mattudakis/ArduinoLEDClock/LEDPCB/PCB_LED_bottom.png

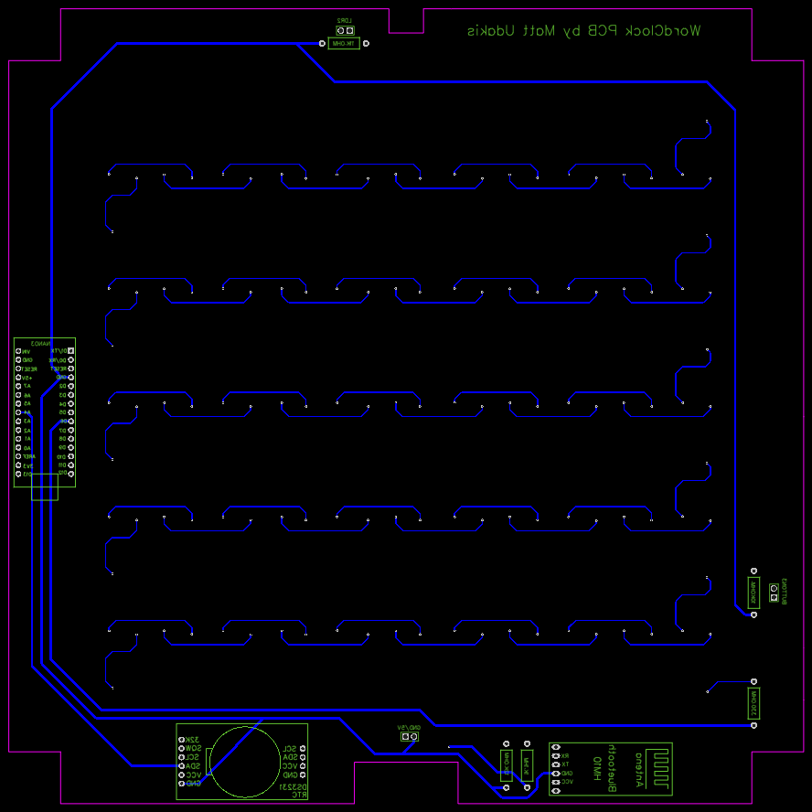
LEDPCB/PCB_LED_bottom.png
