mattudakis/ArduinoLEDClock/LEDPCB/PCB_LED_top.png

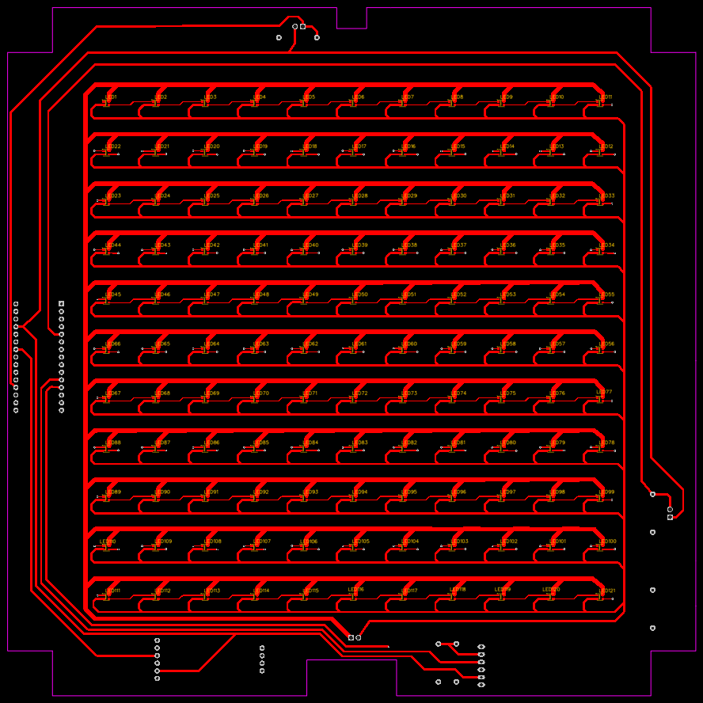
LEDPCB/PCB_LED_top.png
