mattudakis/ArduinoLEDClock/LEDPCB/BOM_LED_array_extra_reconfig_2023-05-14.csv

ID | Name | Designator | Footprint | Quantity | Manufacturer Part | Manufacturer | Supplier | Supplier Part | Price
1 | LED-SMD_4P-L2.0-W2.0-TL_WS2812B-2020 | LED84,LED85,LED86,LED87,LED88,LED1,LED2,LED3,LED4,LED5,LED6,LED7,LED8,LED9,LED10,LED11,LED12,LED13,LED14,LED15,LED16,LED17,LED18,LED19,LED20,LED21,LED22,LED23,LED24,LED25,LED26,LED27,LED28,LED29,LED30,LED31,LED32,LED33,LED34,LED35,LED36,LED37,LED38,LED39,LED40,LED41,LED42,LED43,LED44,LED45,LED46,LED47,LED48,LED49,LED50,LED51,LED52,LED53,LED54,LED55,LED56,LED57,LED58,LED59,LED60,LED61,LED62,LED63,LED64,LED65,LED66,LED67,LED68,LED69,LED70,LED71,LED72,LED73,LED74,LED75,LED76,LED77,LED78,LED79,LED80,LED81,LED82,LED83,LED89,LED90,LED91,LED92,LED93,LED94,LED95,LED96,LED97,LED98,LED99,LED100,LED101,LED102,LED103,LED104,LED105,LED107,LED108,LED109,LED110,LED111,LED112,LED113,LED114,LED115,LED116,LED117,LED118,LED119,LED120,LED121,LED106 | LED-SMD_4P-L2.0-W2.0-TL_WS2812B-2020 | 121
2 | DS3231 | U3 | DS3231 | 1
3 | 330 ohm | 330.OHM | AXIAL-0.5 | 2
4 | button header | BUTTON3 | HDR-2X1/2.54 | 1
5 | ARDUINO_NANO | NANO3 | ARDUINO_NANO | 1
6 | LDR | LDR2 | HDR-2X1/2.54 | 1
7 | 10k | 10K.OHM | AXIAL-0.5 | 1
8 | 2k | 2K.OHM | AXIAL-0.5 | 1
9 | 1k | 1K.1HM | AXIAL-0.5 | 1
10 | Bluetooth | HM11 | BLUETOOTH HC05 HM10 | 1
11 | LED in | GND/5V | HDR-2X1/2.54 | 1
