mattudakis/ArduinoLEDClock/other_workings/fabrication/WordClock_deviders_1.5mmedited.png

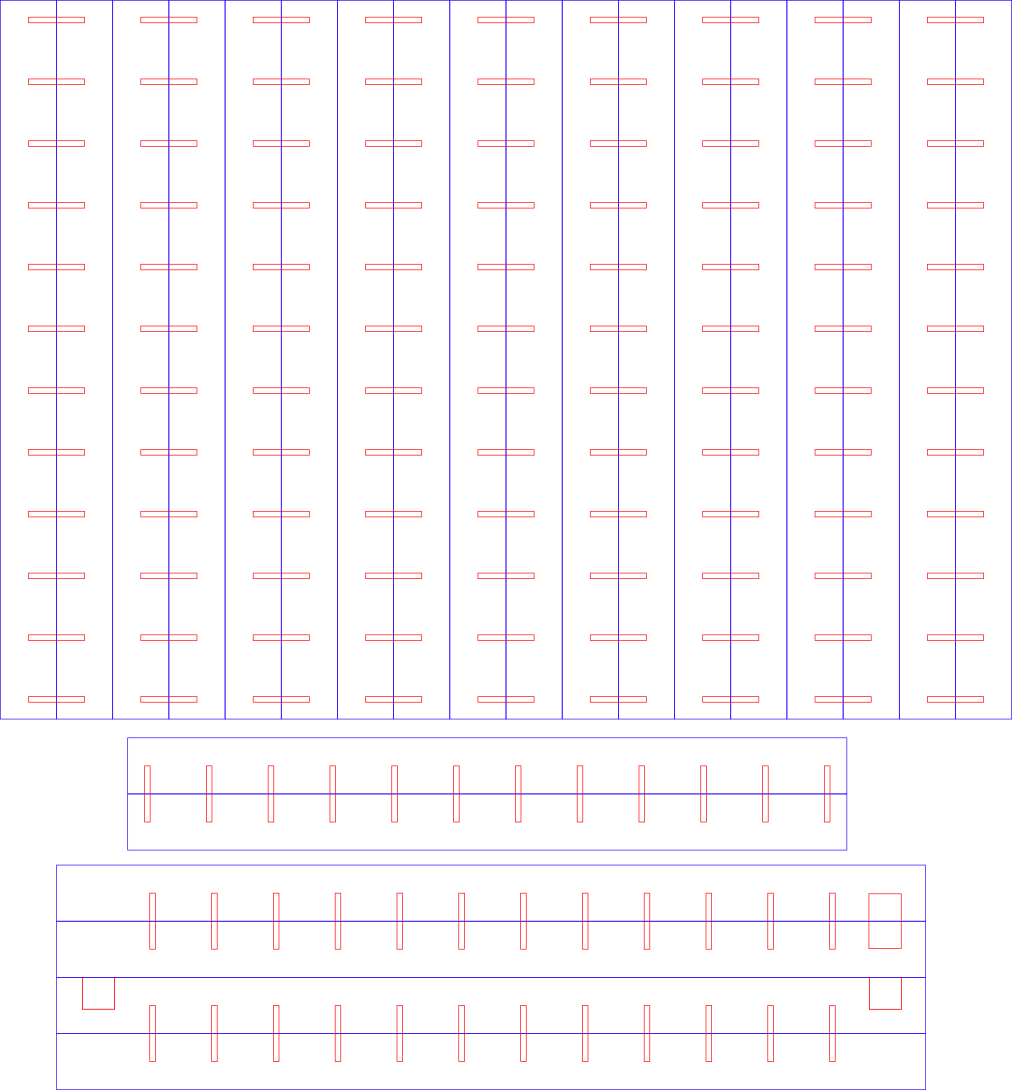
other_workings/fabrication/WordClock_deviders_1.5mmedited.png
