mattudakis/ArduinoLEDClock/(threads)

Thread 1 (2022-09-05):

Add eprom memory functionality

mattudakis, 2022-09-05:
Use the eprom memory of the ardunio board to save user settings
settings to save include:
- LED hue
- Birthdays set via bluetooth
- Brightness thresholds set via bluetooth

mattudakis, 2023-05-14:
This has been addressed and used for storing birthdays that be added and deleted from the eprom memory

Closed 2023-05-14.

Thread 6 (2023-02-25):

SVG Units

AeroSteveO, 2023-02-25:
what are the units in the SVG files, inkscape is reading them as 172mm across rather than 230mm across. The center to center distance on the LED template is also 12mm and not 16.5mm, so the LED strip size called out won't fit the cutouts. The dividers have the slots at 1.5mm which matches the called out material sizes, however the length of them too is for a much smaller layout than the 9"x9" one called out.

mattudakis, 2023-02-27:
It apears that Inkscape has a known issues when importing SVGs with setting incorrect scales.
This can be corrected as shown here: https://www.youtube.com/watch?v=9qiYQDcmmQc

Unfortunatly if you correct the scale issue in inscape and then resave the .svg the dimentions are then incorrect in other vector based softwares such as adobe illustrator

I will update the readme and add additional files specific for inkscape

The correct dimentions for the WordClock_LED_template and the WordClock_Front_text should be 230mm x 230mm
It looks like the WordClock_deviders_1.5mm file has been edited incorrectly due to this issue, which I will rectify.

AeroSteveO, 2023-02-27:
I saw the same problem in LightBurn and CATIA as well. The scaling issue was strangest with the dividers where the slots were the correct 1.5mm while the rest of the size matched the smaller clock size at 7" or about a 12mm LED spacing.

mattudakis, 2023-02-27:
>

Having researched into this a bit more, it seems this is actually an adobe illustrator issue rather than an Inkscape problem.
adobe exports .svgs with a 96ppi whereas the standard for .svgs is 72ppi which is why you were having issues with LightBurn and CATIA as well. I will fix the files to make them fit to the standard 72ppi and upload the files again.

mattudakis, 2023-02-27:
The following commit ( 36f0f84 ) should have fixed this issue. I'll update the readme as well to mention compatability issues with adobe illustrator.

Closed 2023-02-27.

Thread 8 (2023-05-14):

The RTC doesnt seem to keep time after powering down

mattudakis, 2023-05-14:
When powering down the clock doesnt seem to keep the correct time as previously. Might be due to the release of new DS3232RTC libraries

mattudakis, 2023-05-14:
This is now resolved. In version 2.0 and onwards of the DS3232RTC library. RTC.begin() is needed in the setup void.
This is detailed in the documentation for this library

Closed 2023-05-14.

Thread 9 (2023-07-01):

Bluetooth serial input won't work with \r carriage return

mattudakis, 2023-07-01:
currently only detects strings with a new line '\n'. If '\r\n' is sent together, Bluetooth commands are not detected correctly. BLE apps by default send '\r\n' forcing users to alter settings. To fix Need to insert logic to detect if string contains '\r' after parsing input and remove.
Alternatively could do read string until '/r' or '/n'

Thread 10 (2023-07-30):

Add smoothing to analogue brightness read.

mattudakis, 2023-07-30:
In lower light conditions the mapping of analogue photo resistor to FastLED brightness leads to fluctuations. A simple box filter should hopefully stop this.

Can use built in arduino smooth() example
