mattudakis/ArduinoLEDClock/Fabrication/Backplate_0_01pt_with_engrave.pdf

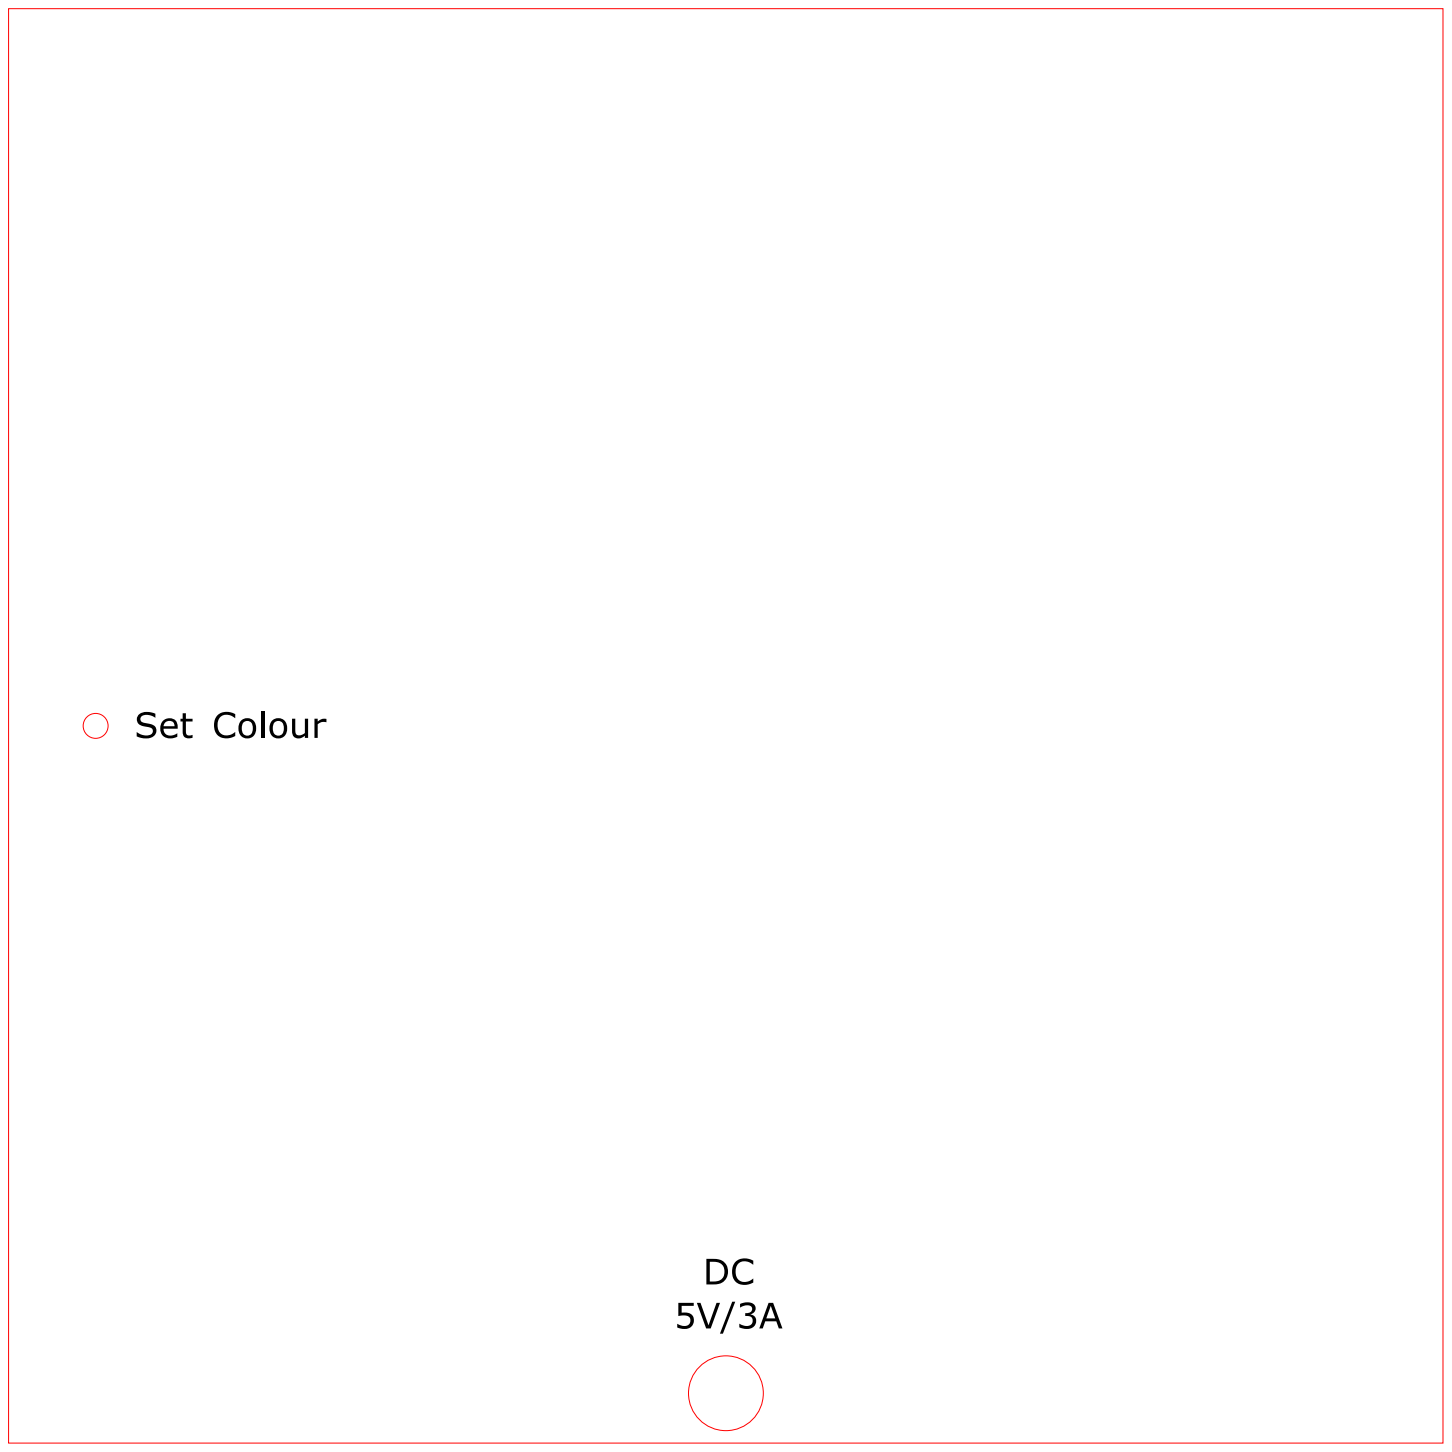
[picture p26: page 1]
