mattudakis/ArduinoLEDClock/Fabrication/WordClock_Front_text.pdf

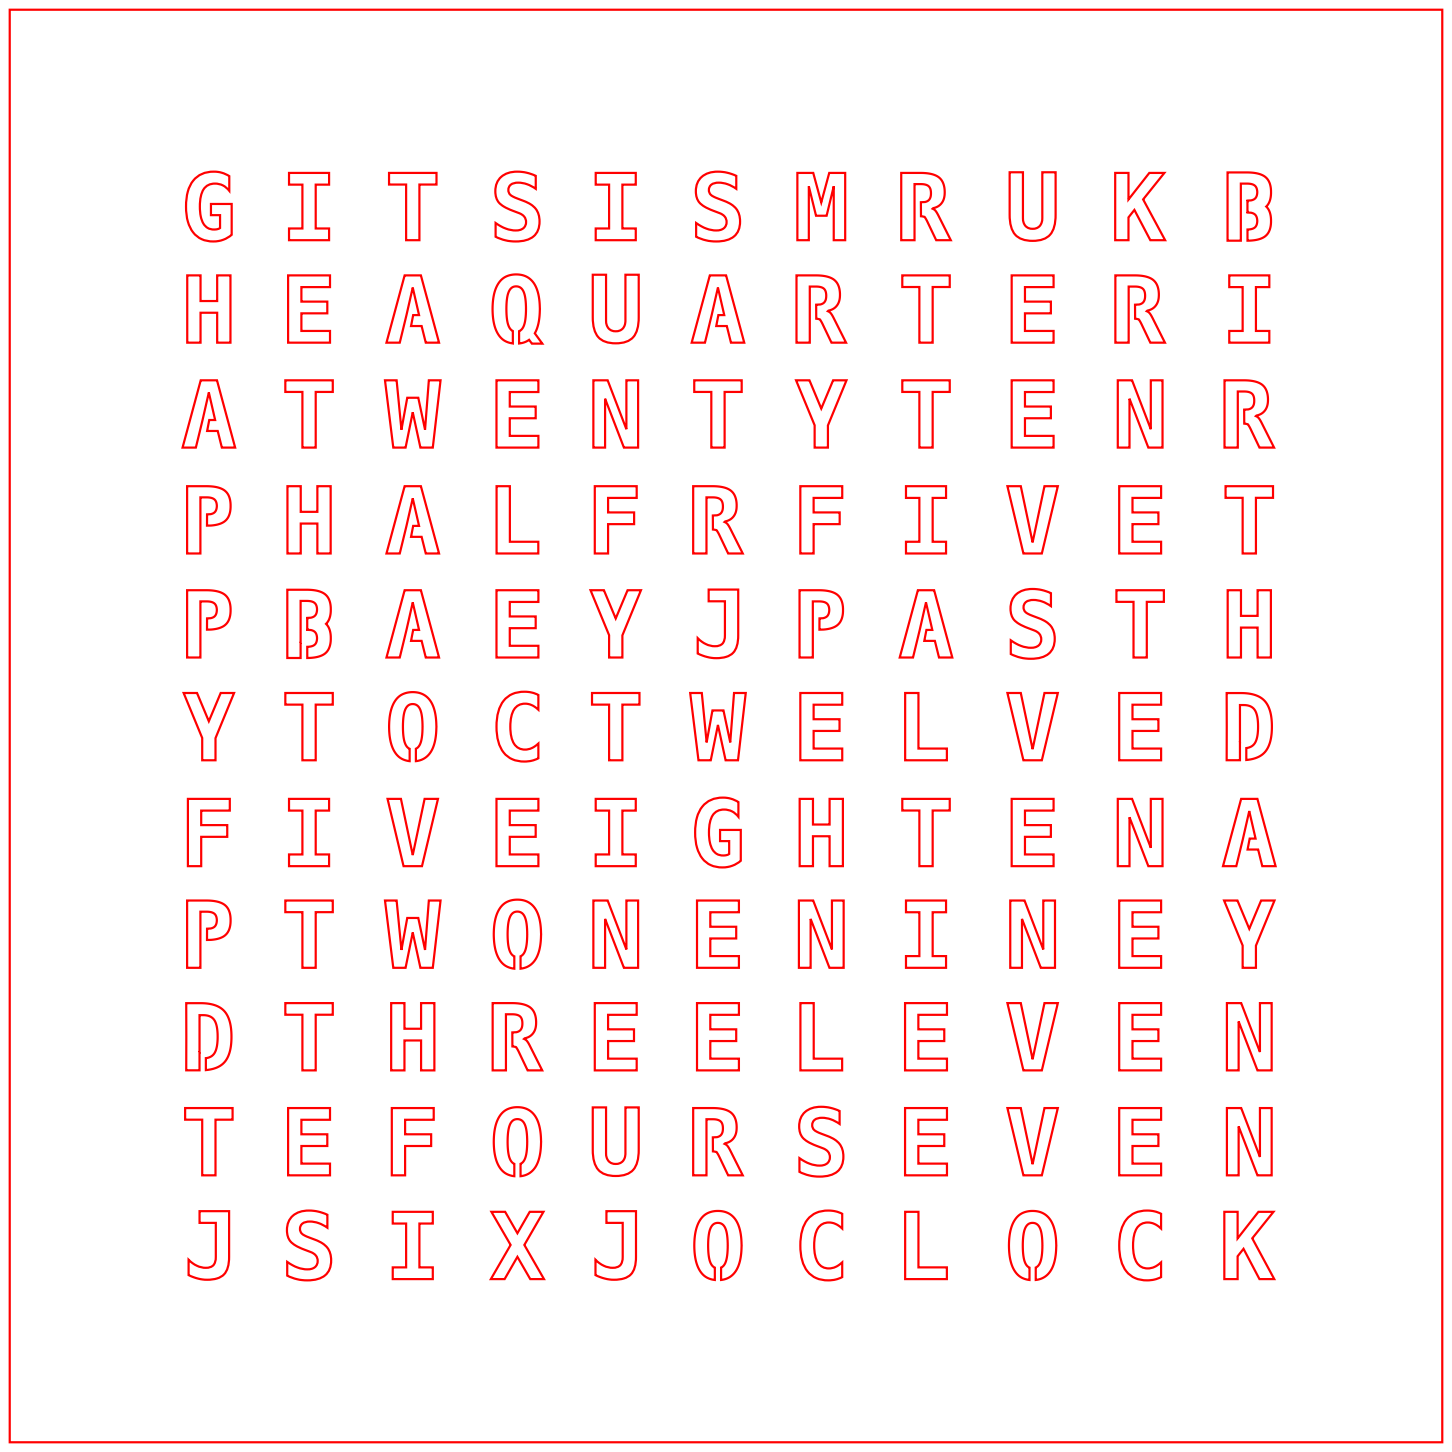
[picture p27: page 1]
