mattudakis/ArduinoLEDClock/Fabrication/WordClock_LED_template.pdf

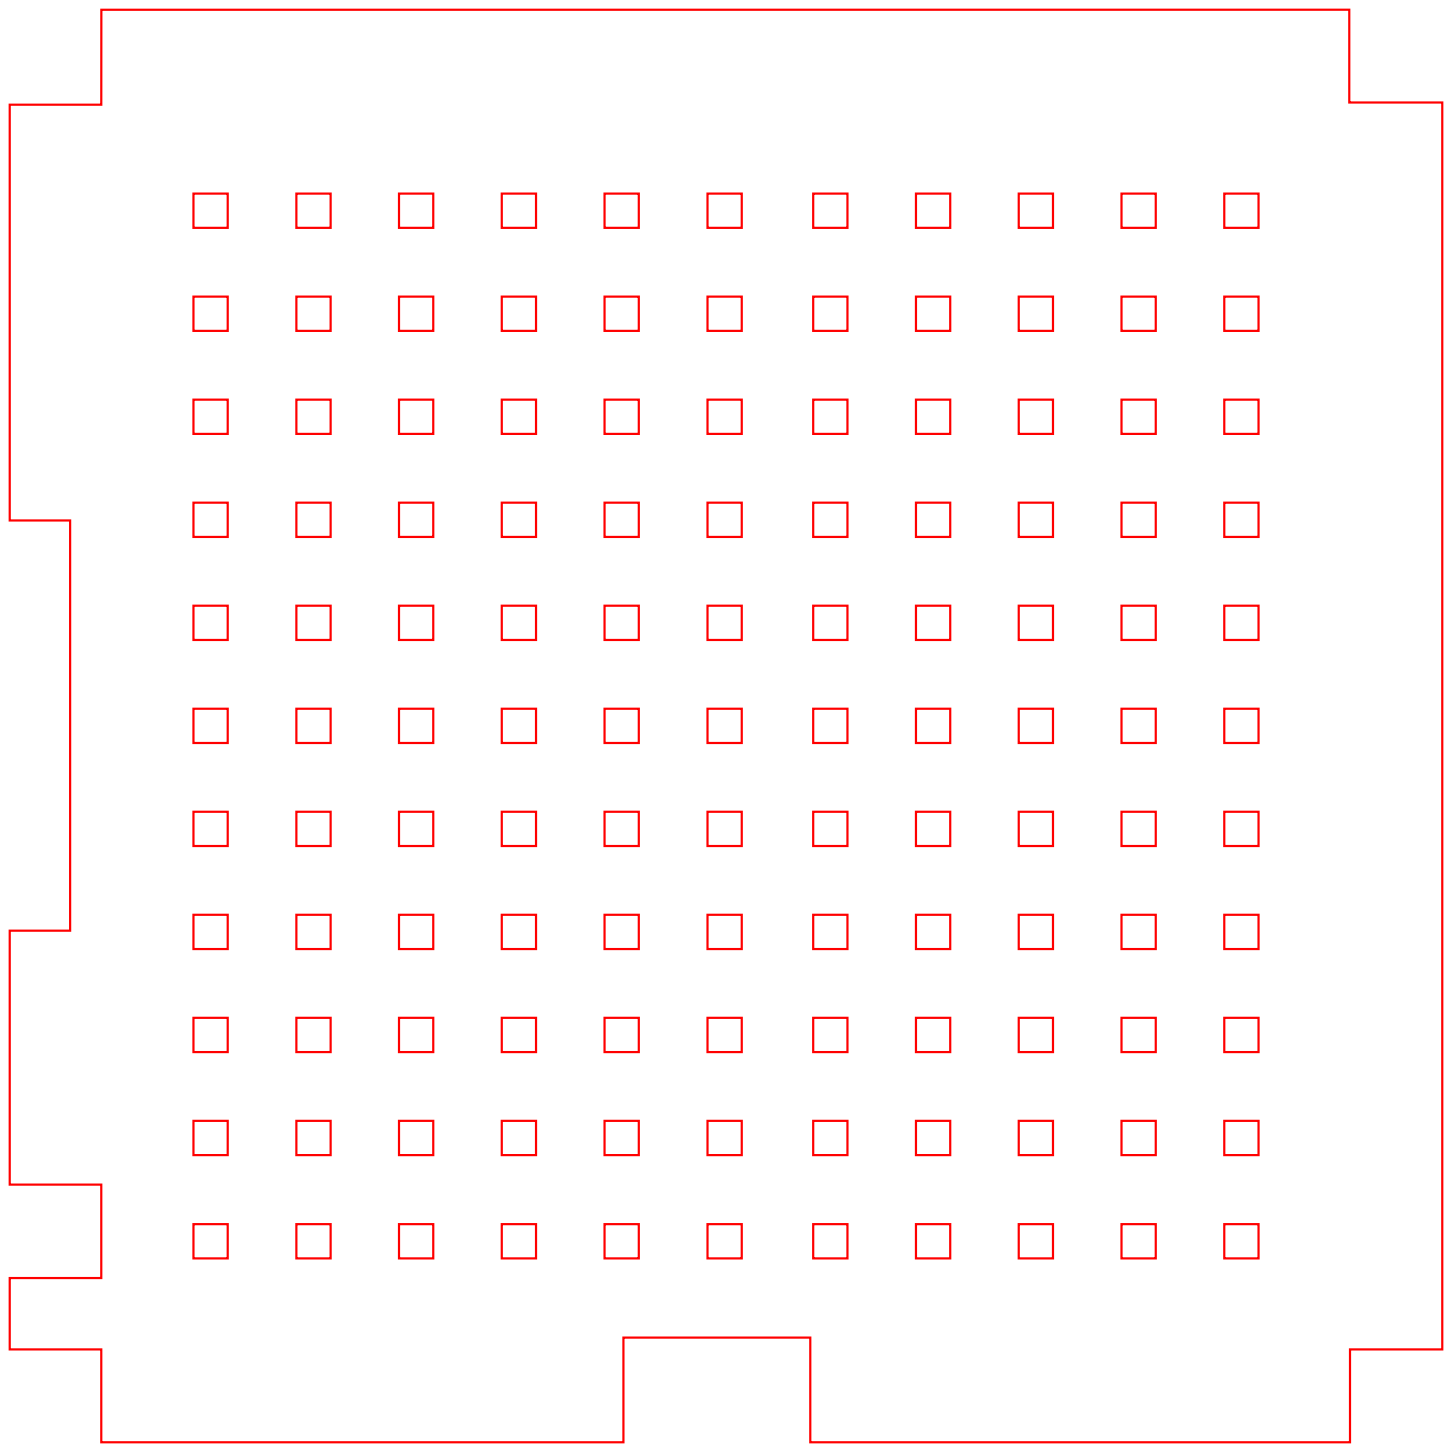
[picture p28: page 1]
