mattudakis/ArduinoLEDClock/CustomPCB/WordClock_Schematic.pdf

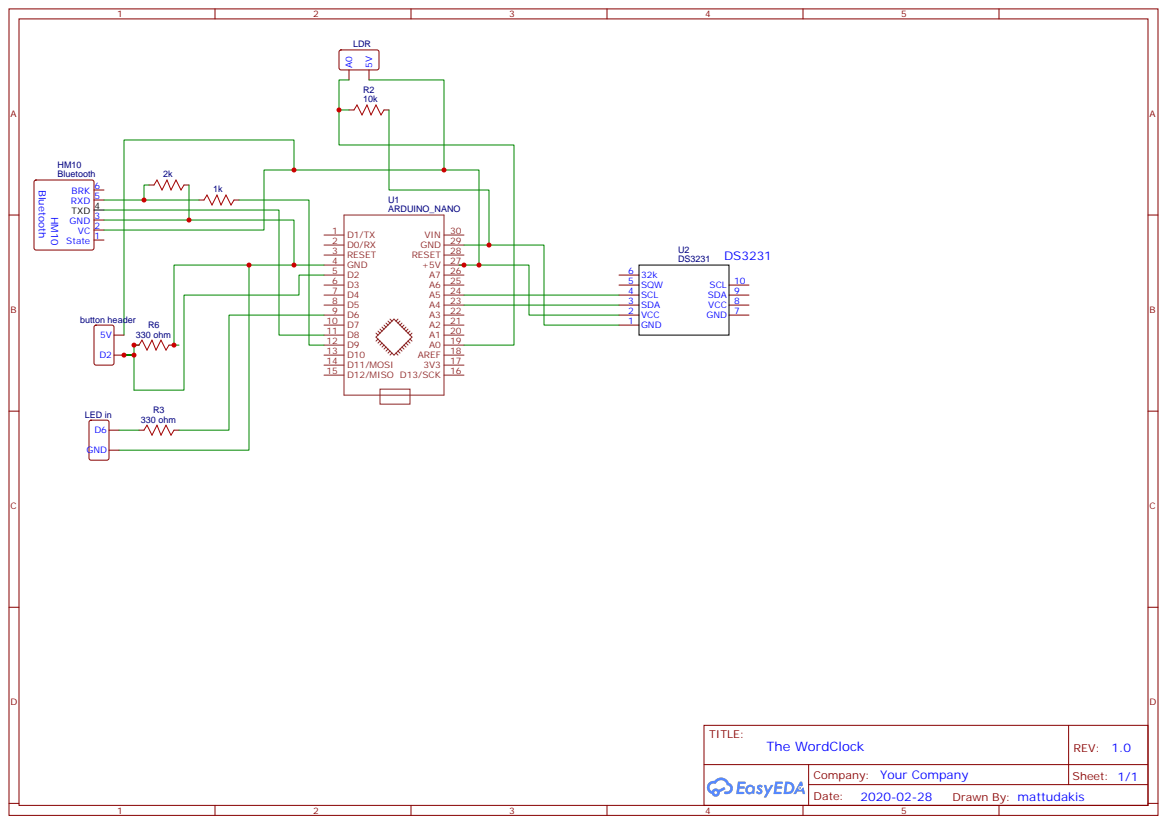
[picture p29: page 1]
