mattudakis/ArduinoLEDClock/CustomPCB/WordClock_PCB.pdf

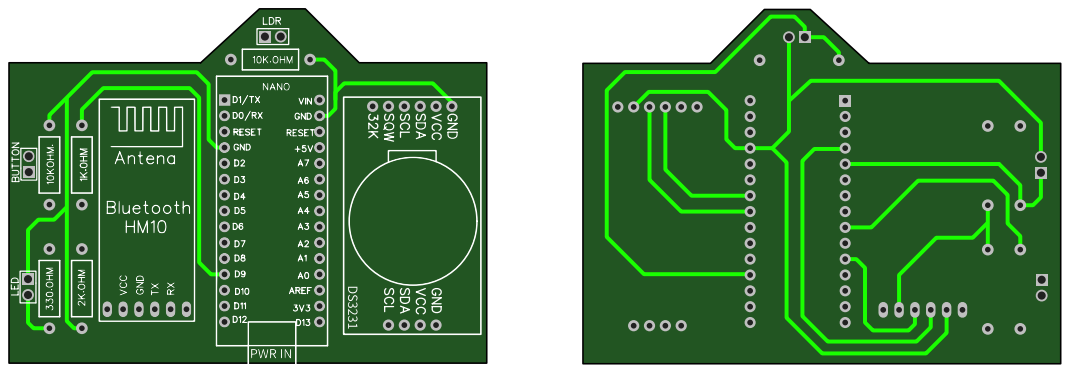
[picture p30: page 1]
