mattudakis/ArduinoLEDClock/(list of files, drawings)

Other design files:
CustomPCB/WordClock_PCB_easyEDA.json
CustomPCB/WordClock_SCH_easyEDA.json
