mattudakis/ArduinoLEDClock/(commit log)

2022-09-05 Main arduino sketches for WordClock
2022-11-21 Update README.md
    updated on sourcing Frames
2023-01-03 update to HM-10 with correct pin configuration
    [HM10_bluetooth_settings.ino]
2023-01-03 updated the readme file with heatshrink
2023-01-03 Photos added of essembly process
    Pictures of the following:
    - frame essembly
    - power jack essembly
    - LED array soldering
    - Final PCB
    - Photoresistor
    - Push button
    - Back plate essembly
2023-01-20 Changed error components table for the LED strip inter LED distance from 12mm to correct 16.5mm
2023-02-27 updated the circuit diagram labels
2023-03-15 Accidently pushed the working progress. This should correct with missing closing brackets.
    [WordClock_Main.ino]
2023-05-14 Added back plate design that can be laser cut
2023-05-14 Updated the main sketch to fix the issue with the RTC not keeping time with the new update
    - Also added the ability to change the birthdays over bluetooth and save them into the eprom memory
    - bluetooth can now listbdays, removebdays, addbdays, settime and gettime
    [WordClock_Main.ino]
2023-05-14 Add a custom LED PCB
    This contains all the addressable LEDs on a PCB that can be pre-assembled
    - Through holes are left to add the Arduino, RTC, HM-10 and resistors.
    - This saves a lot of time soldering the LED strips.
    - Can be put fabricated and assembled online at JLCPCB
    [BOM_LED_array_extra_reconfig_2023-05-14.csv, PickAndPlace_LED_array_extra_reconfig_2023-05-14.csv]
2023-05-14 added photos of the large LED PCB
2023-05-14 added SVg images of PCBs
2023-05-20 changed the animation settings to work more smoothly with the 2020 LEDS
2023-06-06 altered the max threshold and the max brightness of the LEDs for the auto brightness settings
